zanppa/smart_socket/docs/main_page.png

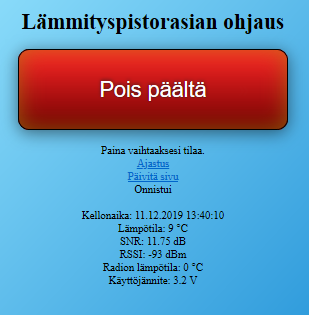
docs/main_page.png
