zanppa/smart_socket/docs/timing.png

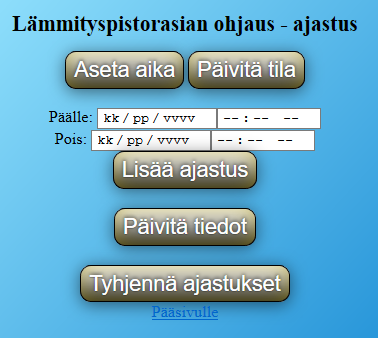
docs/timing.png
