zanppa/smart_socket/README.md

# smart_socket
A "smart" remote controlled power socket
