zanppa/smart_socket/model/readme.md

This directory contains 3D model(s) for the smart socket (concepts).
