zanppa/smart_socket/model/horizontal.png

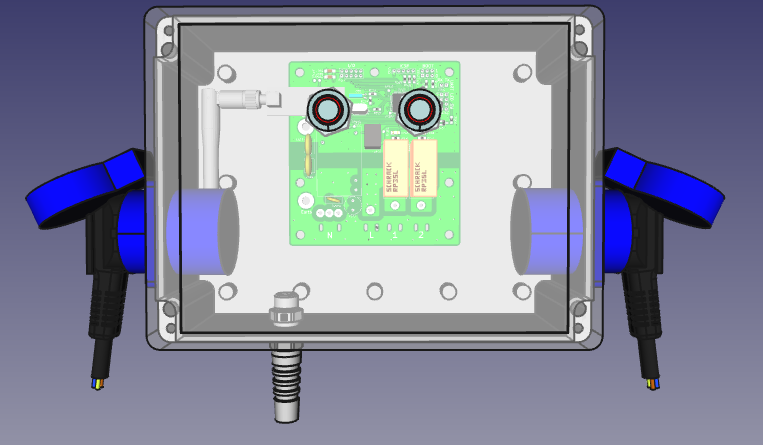
model/horizontal.png
