zanppa/smart_socket/model/vertical.png

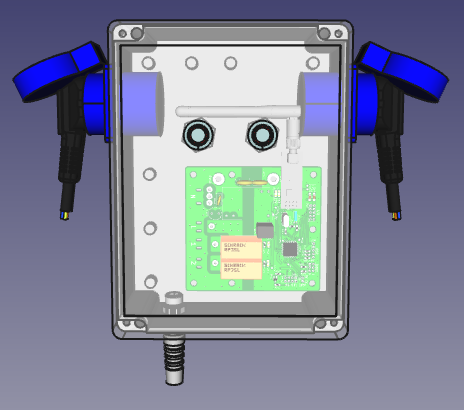
model/vertical.png
