zanppa/smart_socket/model/Horizontal_1.FCStd

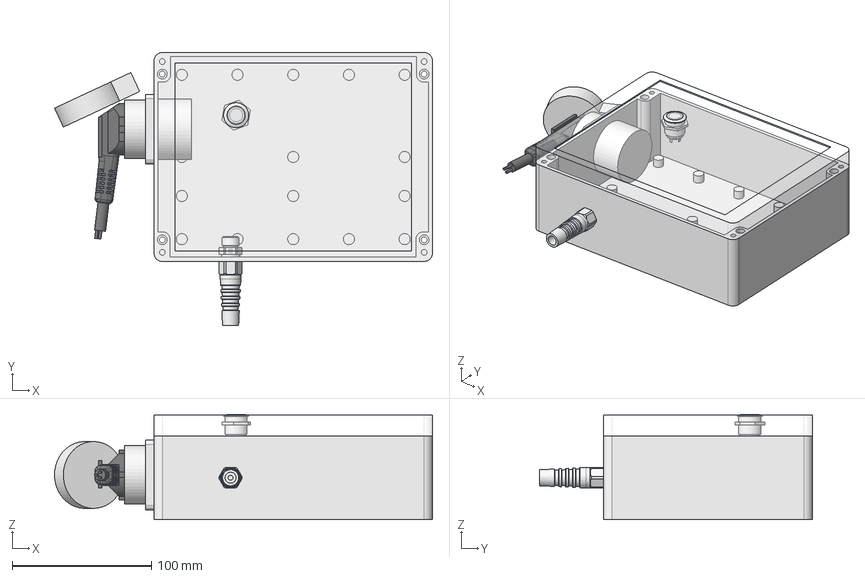
[picture p5: CAD file, 2020-01-01]
model/Horizontal_1.FCStd
271.4 x 196.0 x 75.4 mm
Kotelo
Kansi
Button
Pistorasia1
M12 cable gland
