zanppa/smart_socket/model/Vertical_1.FCStd

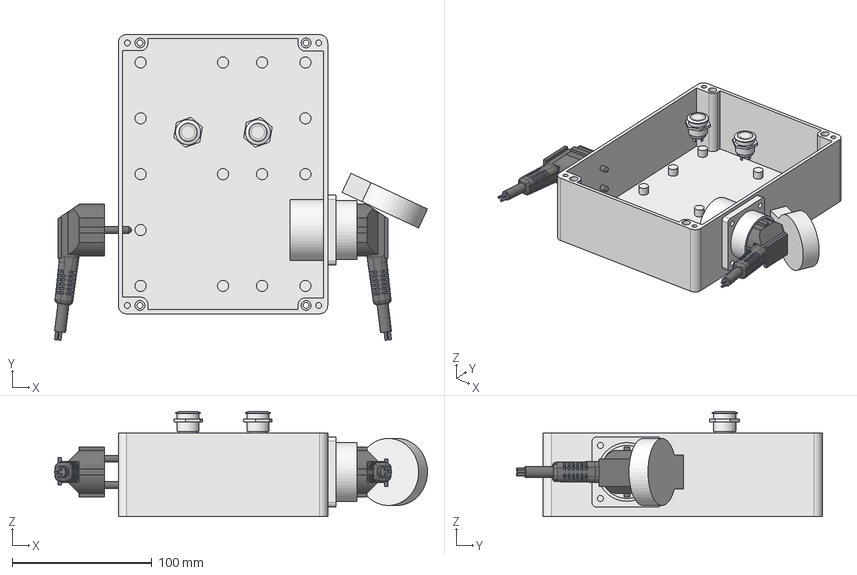
[picture p6: CAD file, 2020-01-01]
model/Vertical_1.FCStd
267.1 x 219.1 x 75.4 mm
Kotelo
Button1
Pistorasia2
Button2
