zanppa/smart_socket/electronics/gerbers/Socket-B.SilkS.pdf

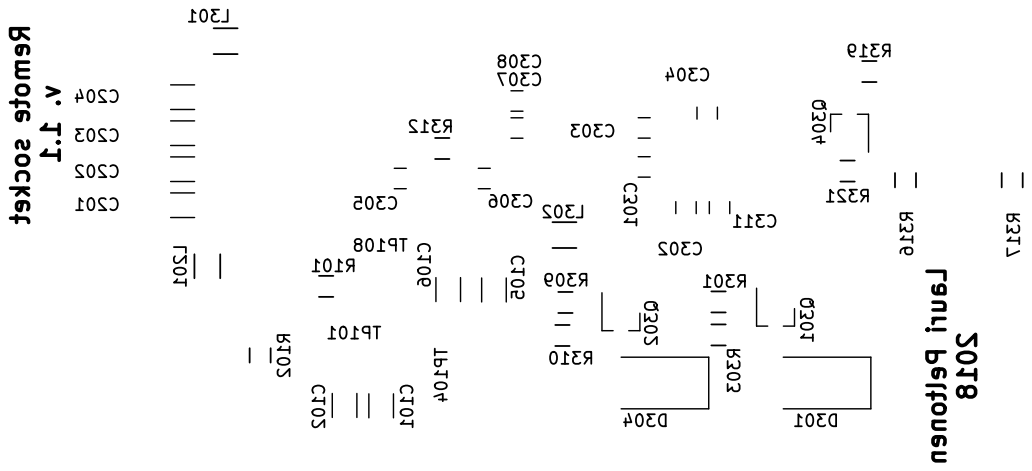
[picture p7: page 1]

Lauri Peltonen 2018 Remote socket v. 1.1
