zanppa/smart_socket/electronics/schematic/socket.pdf

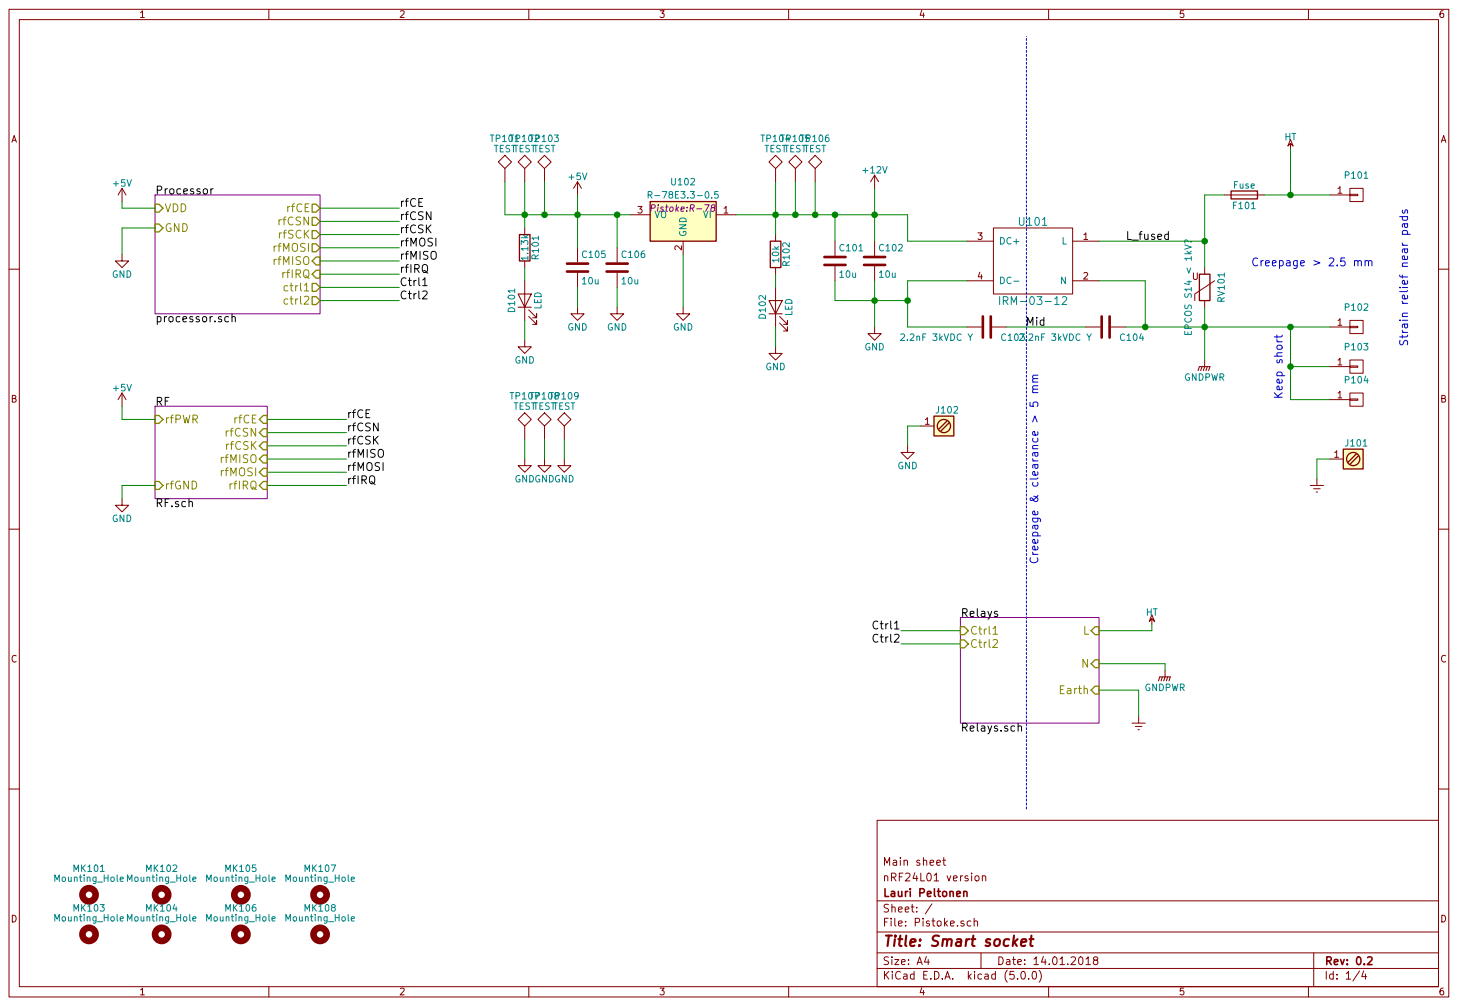
[picture p8: page 1]

1 P104 Processor processor.sch VDD GND

Id: 1/4 Title: Smart socket File: Pistoke.sch Sheet: / Lauri Peltonen

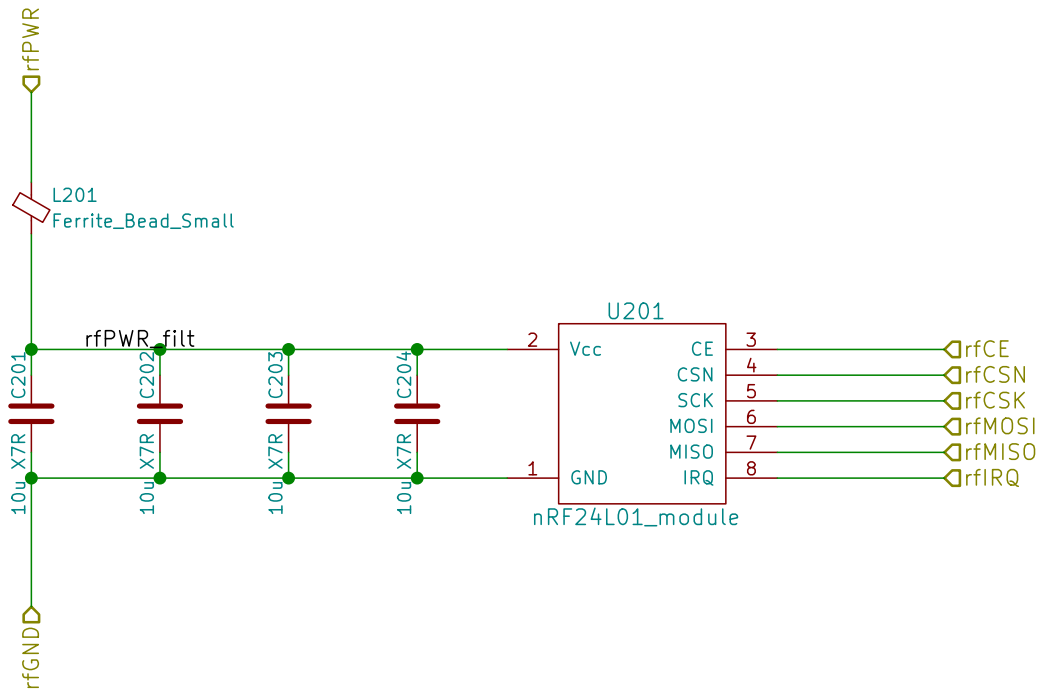
[picture p9: page 2]

Id: 2/4 Title: Smart socket File: RF.sch Sheet: /RF/ Lauri Peltonen

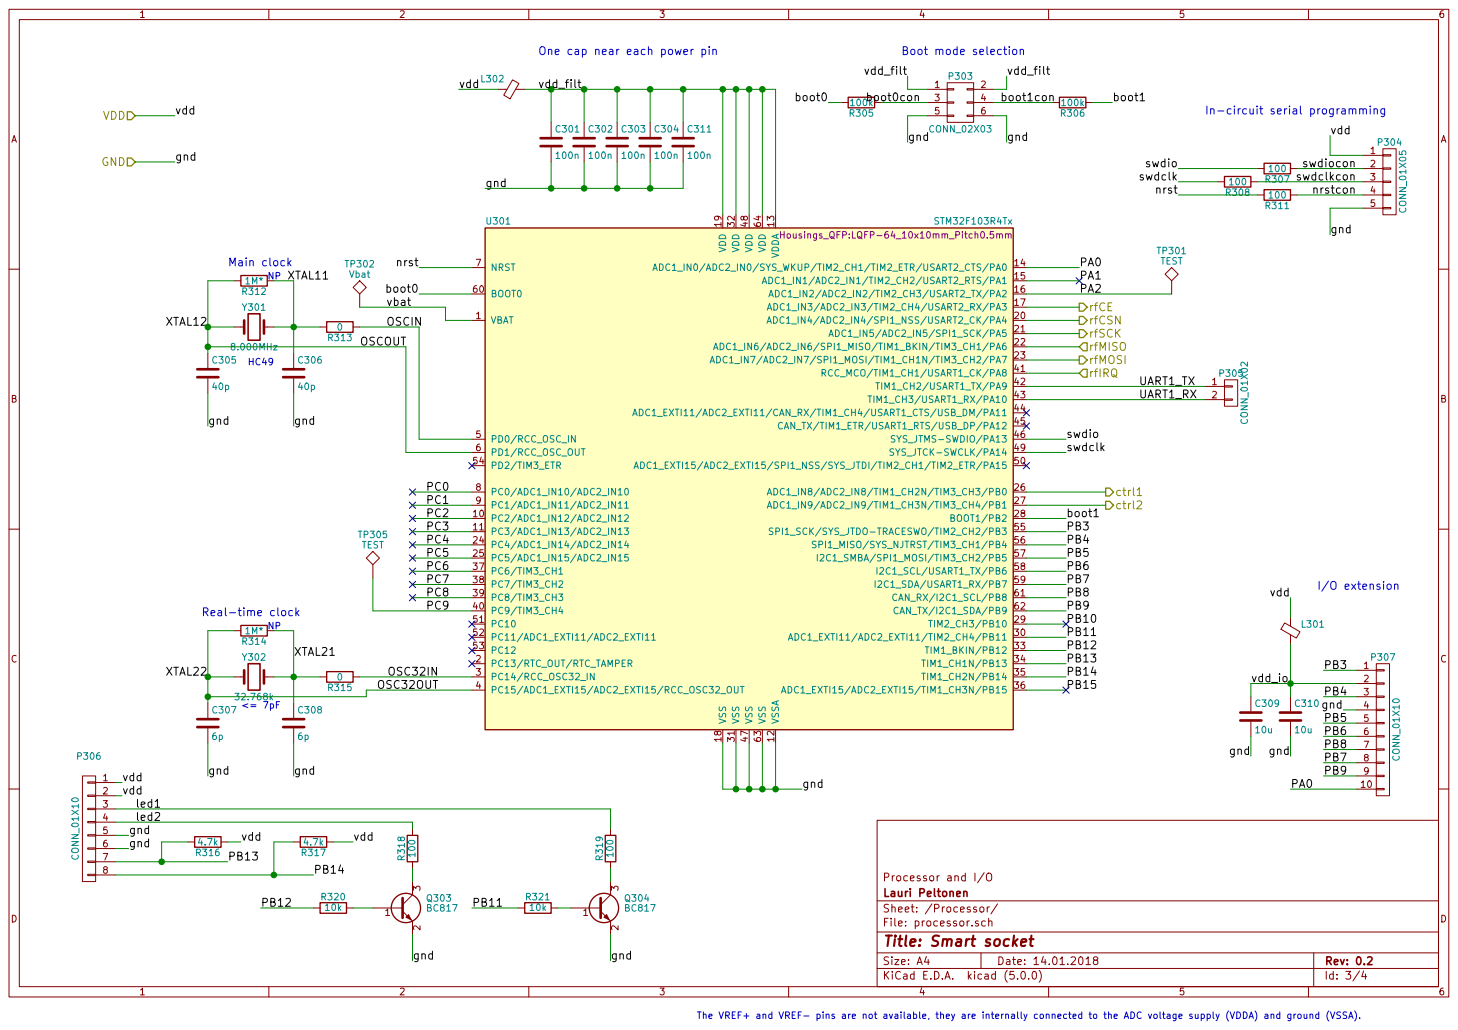
[picture p10: page 3]

One cap near each power pin

In-circuit serial programming

File: processor.sch Sheet: /Processor/ Lauri Peltonen Processor and I/O

Id: 3/4 Title: Smart socket

The VREF+ and VREF- pins are not available, they are internally connected to the ADC voltage supply (VDDA) and ground (VSSA).

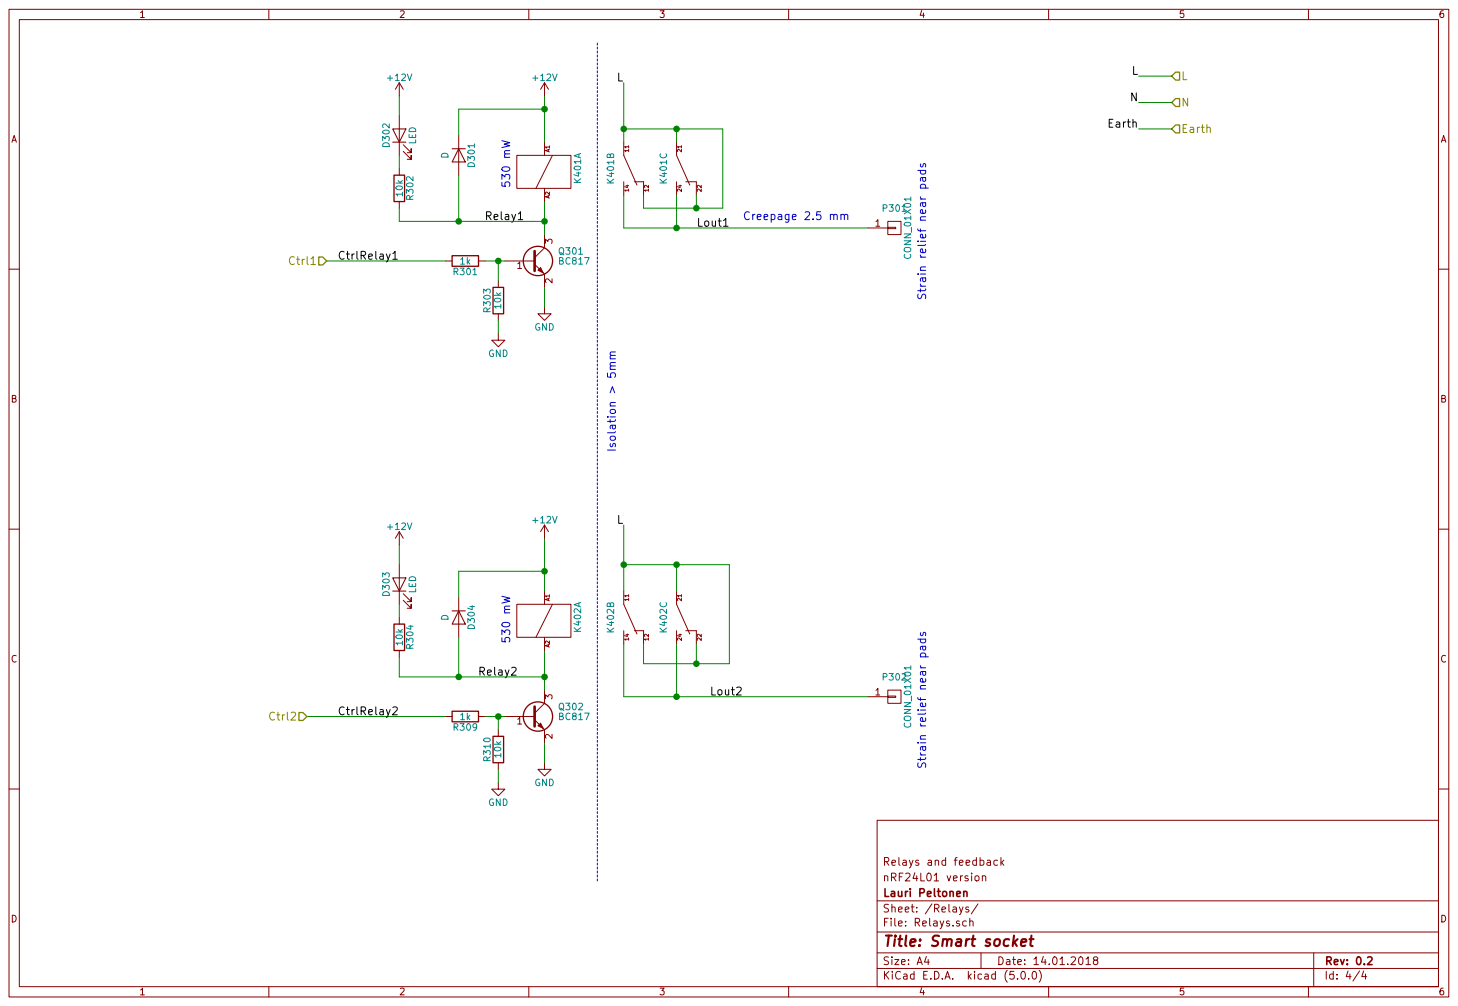
[picture p11: page 4]

Sheet: /Relays/ Lauri Peltonen

File: Relays.sch
Id: 4/4 Title: Smart socket
