zanppa/smart_socket/electronics/gerbers/Socket-B.Cu.pdf

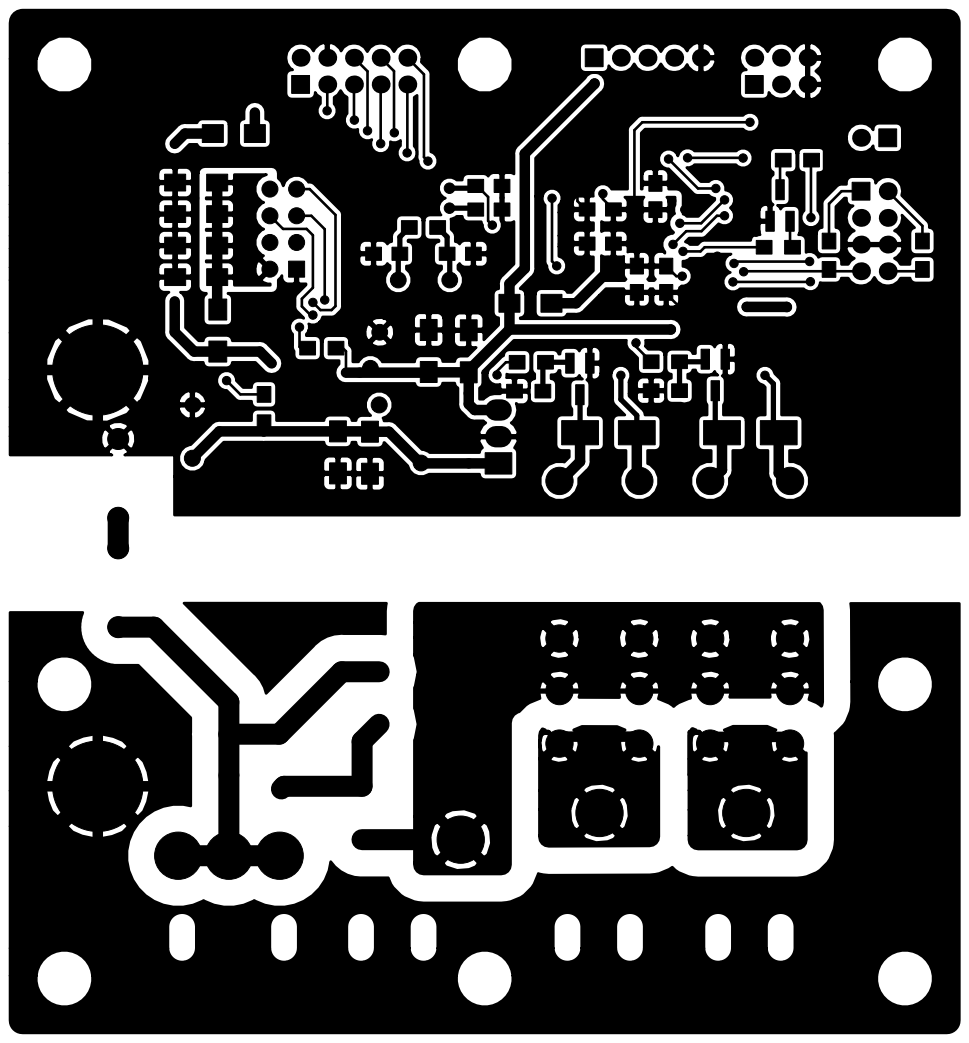
[picture p12: page 1]
