zanppa/smart_socket/electronics/gerbers/Socket-B.Mask.pdf

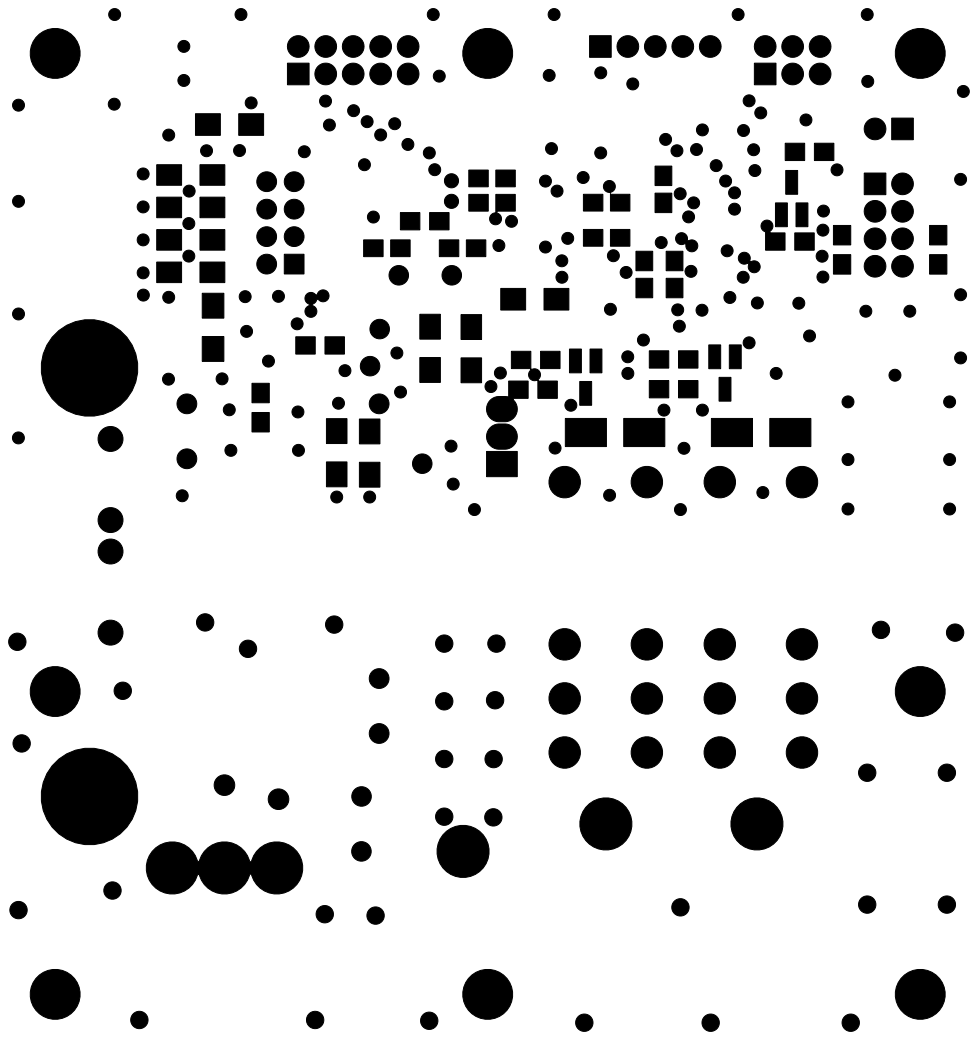
[picture p13: page 1]
