zanppa/smart_socket/electronics/gerbers/Socket-Edge.Cuts.pdf

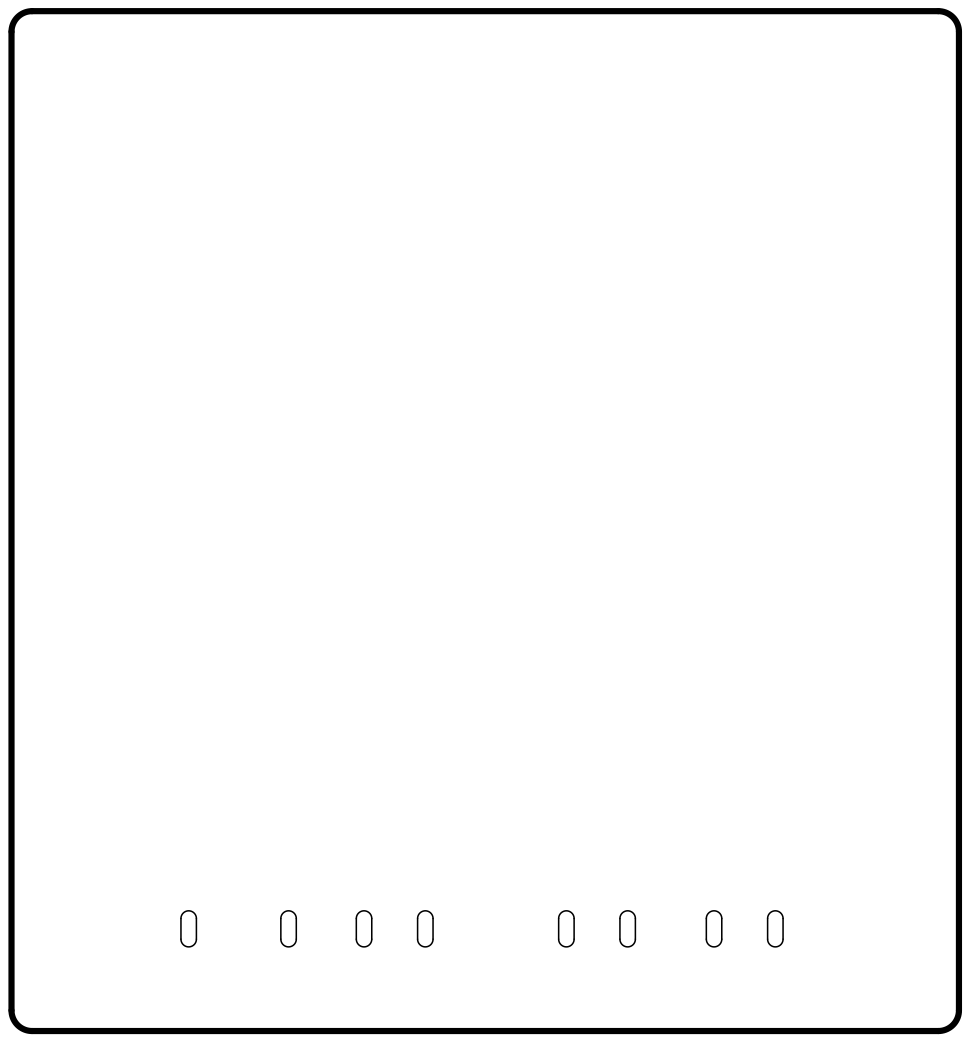
[picture p14: page 1]
