zanppa/smart_socket/electronics/gerbers/Socket-F.Cu.pdf

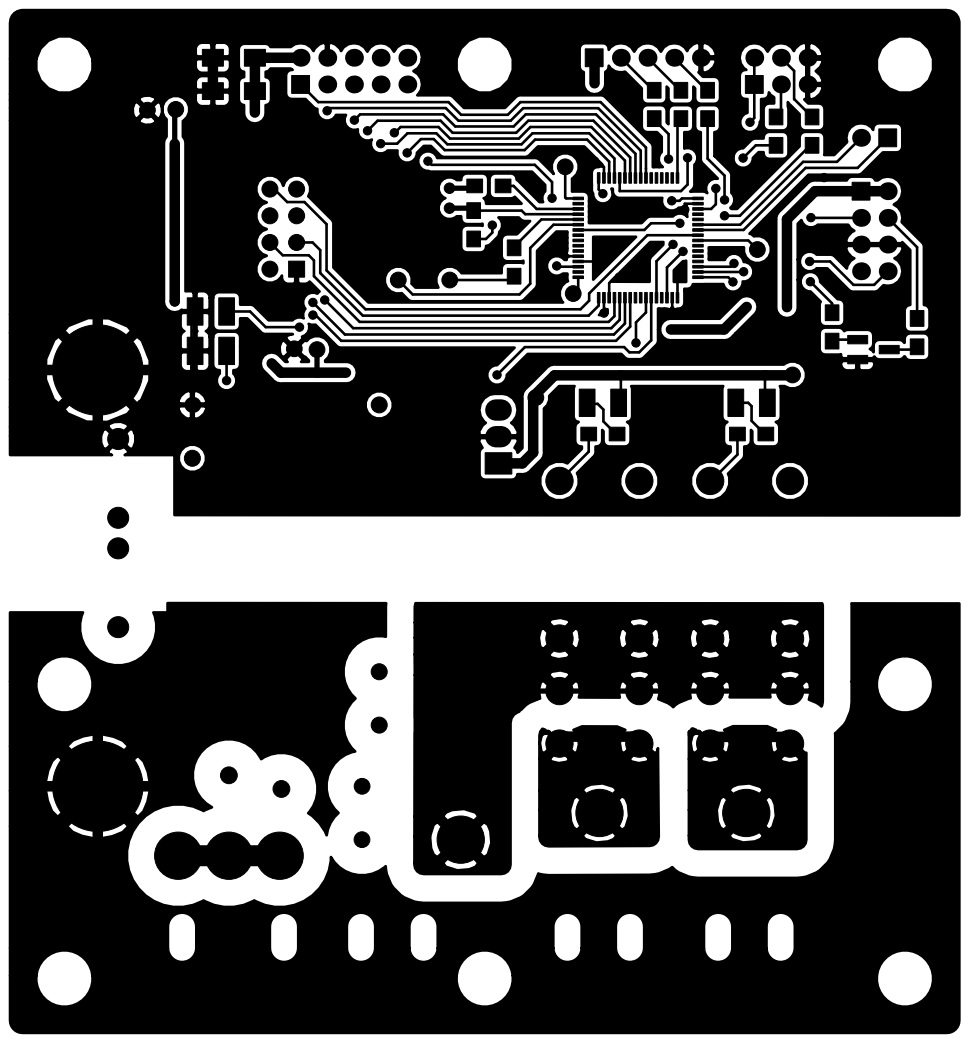
[picture p15: page 1]
