zanppa/smart_socket/electronics/gerbers/Socket-F.Mask.pdf

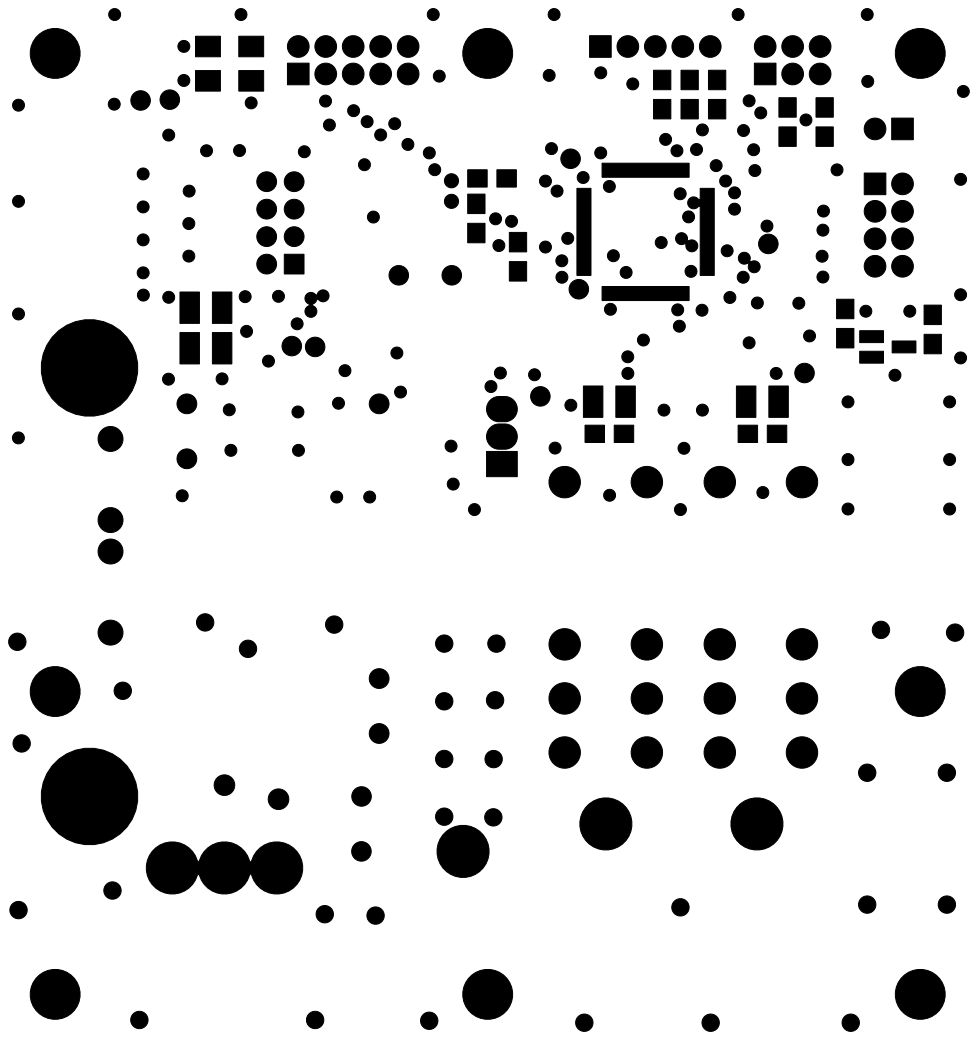
[picture p16: page 1]
