zanppa/smart_socket/electronics/gerbers/Socket-F.SilkS.pdf

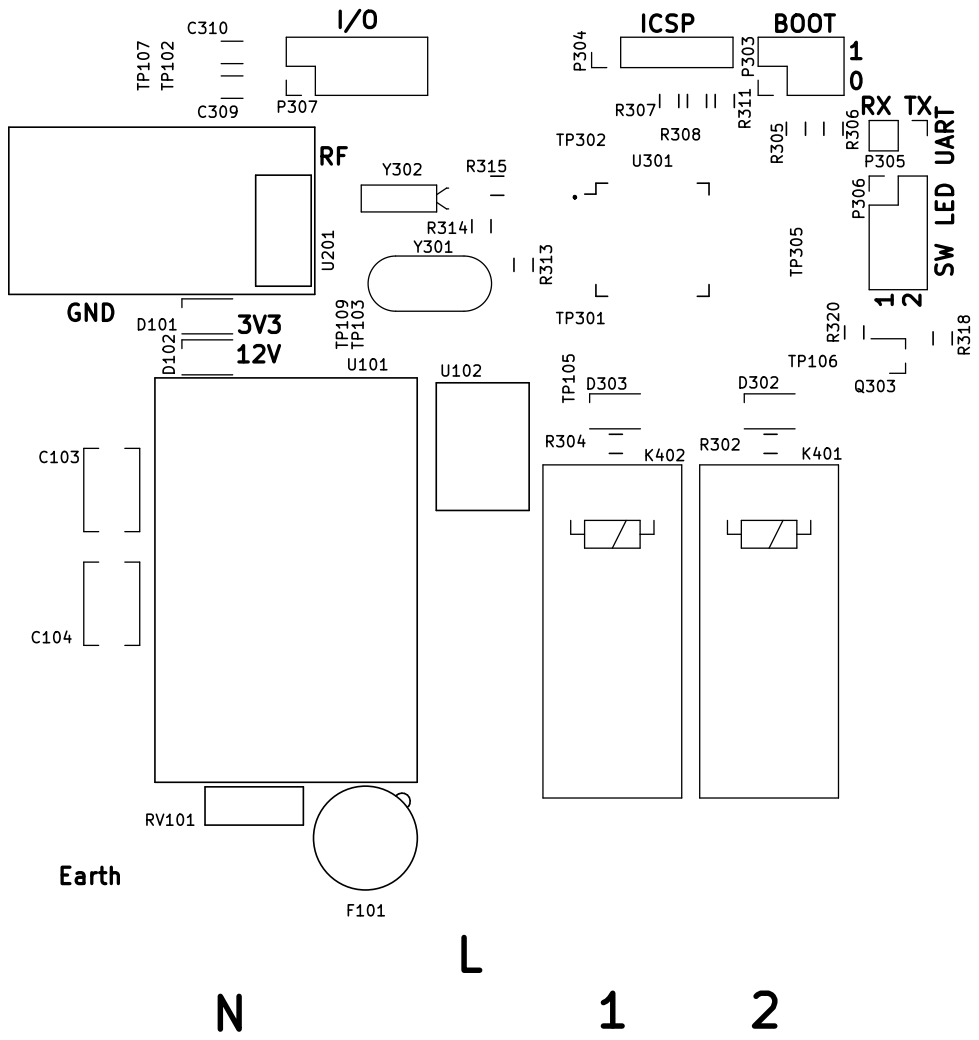
[picture p17: page 1]
