zanppa/smart_socket/electronics/kicad/Socket.kicad_pcb

## KiCad design electronics/kicad/Socket.kicad_pcb (2020-01-02)

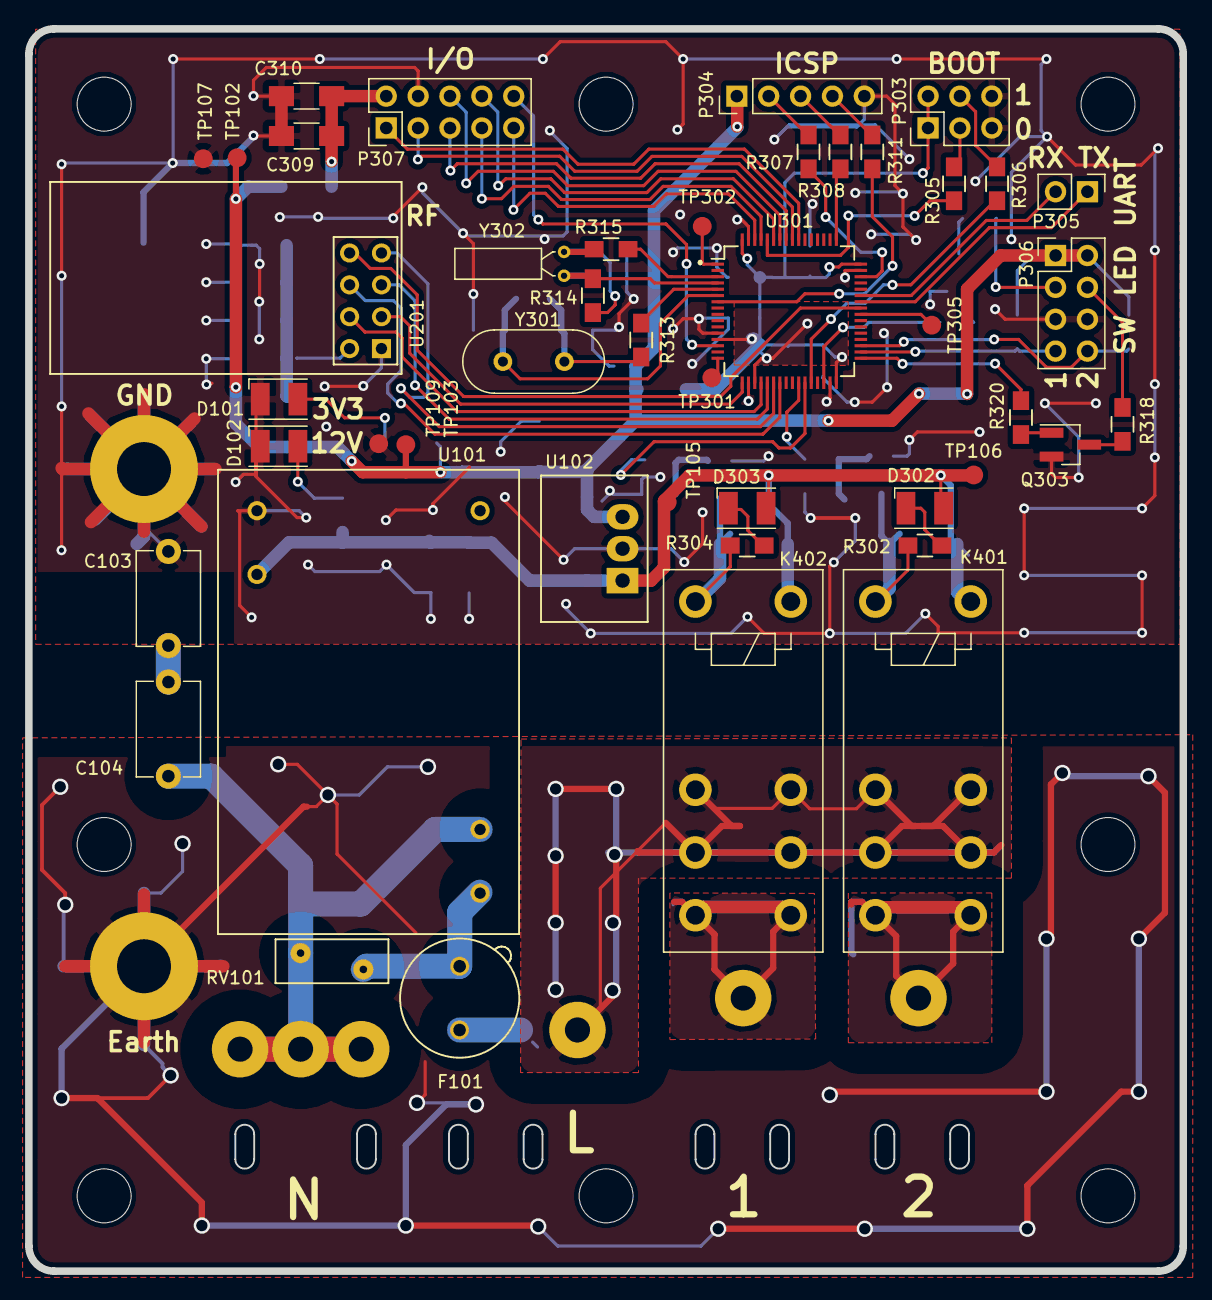
[picture p18: board Socket.kicad_pcb from above]

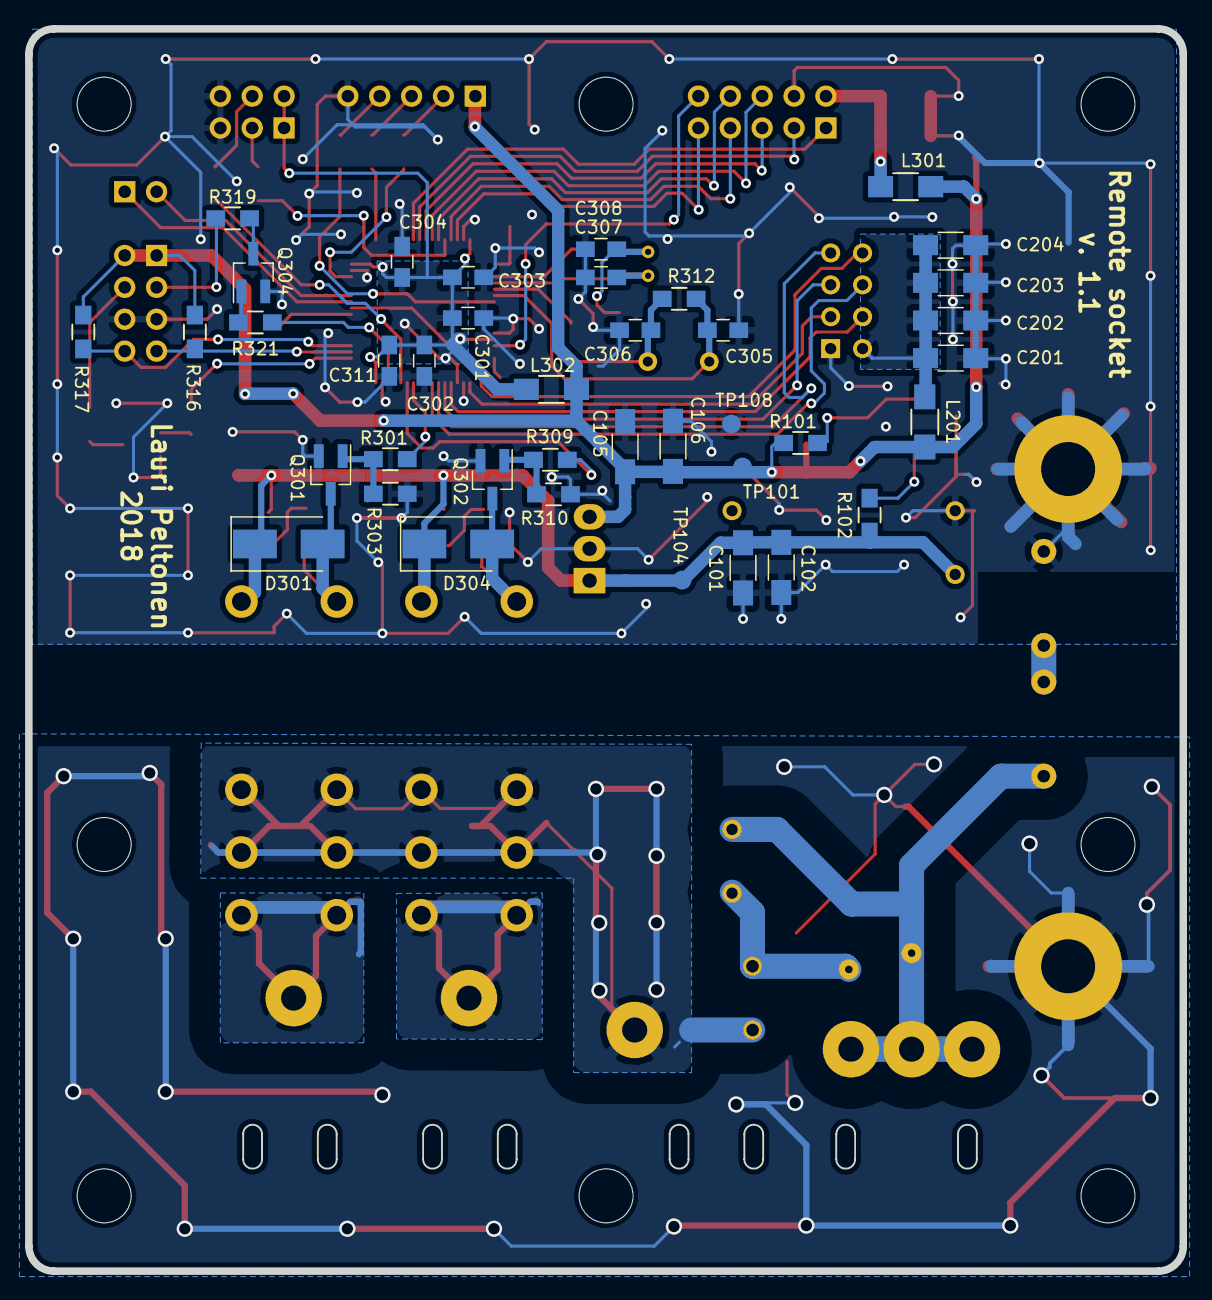
[picture p19: board Socket.kicad_pcb from below]

Board: 2 copper layers, 92.0 x 99.0 mm, 100 parts (39 on the bottom side), 67 nets.

Parts:
C101, C102, C105, C106, C309, C310: 10u; C_1206_HandSoldering
C103, C104: 2.2nF 3kVDC Y; C_Disc_D7.5mm_W5.0mm_P7.50mm
C201, C202, C203, C204: 10u X7R; C_1206_HandSoldering
C301, C302, C303, C304, C311: 100n; C_0805_HandSoldering
C305, C306: 40p; C_0805_HandSoldering
C307, C308: 8p; C_0805_HandSoldering
D101, D102, D302, D303: LED; LED_PLCC-2
D301, D304: D; D_SMB_Handsoldering
F101: Fuse; Fuseholder_Fuse_TR5_Littlefuse-No560_No460
J101, J102: Screw_Terminal_1x01; MountingHole_4.3mm_M4_Pad
K401, K402: GZSH-12V; Relay_SPDT_Goodsky_GZ
L201, L301, L302: Ferrite_Bead_Small; R_1206_HandSoldering
MK101, MK102, MK103, MK104, MK105, MK106, MK107, MK108: Mounting_Hole; MountingHole_4.3mm_M4
P101, P102, P103, P104, P301, P302: CONN_01X01; SolderWirePad_single_2mmDrill
P303: CONN_02X03; Pin_Header_Straight_2x03_Pitch2.54mm
P304: CONN_01X05; Pin_Header_Straight_1x05_Pitch2.54mm
P305: CONN_01X02; Pin_Header_Straight_1x02_Pitch2.54mm
P306: CONN_01X10; Pin_Header_Straight_2x04_Pitch2.54mm
P307: CONN_01X10; Pin_Header_Straight_2x05_Pitch2.54mm
Q301, Q302, Q303, Q304: BC817; SOT-23_Handsoldering
R101: 1.13k; R_0805_HandSoldering
R102, R302, R303, R304, R310, R320, R321: 10k; R_0805_HandSoldering
R301, R309: 1k; R_0805_HandSoldering
R305, R306: 100k; R_0805_HandSoldering
R307, R308, R311, R318, R319: 100; R_0805_HandSoldering
R312, R314: 1M*; R_0805_HandSoldering
R313, R315: 0; R_0805_HandSoldering
R316, R317: 4.7k; R_0805_HandSoldering
RV101: EPCOS S14 < 1kV?; RV_Disc_D9_W3.5_P5
TP101, TP102, TP103, TP104, TP105, TP106, TP107, TP108, TP109, TP301, TP305: TEST; Measurement_Point_Round-SMD-Pad_Small
TP302: Vbat; Measurement_Point_Round-SMD-Pad_Small
U101: IRM-03-12; IRM-03
U102: R-78E3.3-0.5; R-78
U201: nRF24L01_module
U301: STM32F103R4Tx; LQFP-64_10x10mm_Pitch0.5mm
Y301: 8.000MHz; Crystal_HC18-U_Vertical
Y302: 32.768k; Crystal_C26-LF_d2.1mm_l6.5mm_Horizontal

Connections:
+5V: C105.1, C106.1, L201.1, L301.1, L302.1, P304.1, P306.1, P306.2, R101.1, R316.1, R317.1, TP101.1, TP102.1, TP103.1, U102.3
+12V: C101.1, C102.1, D301.1, D302.2, D303.2, D304.1, K401.A1, K402.A1, R102.1, TP104.1, TP105.1, TP106.1, U101.3, U102.1
/Ctrl1: R301.2, U301.26
/Ctrl2: R309.2, U301.27
/L_fused: F101.2, RV101.2, U101.1
/Mid: C103.1, C104.2
/Processor/OSC32IN: R315.1, U301.3
/Processor/OSC32OUT: C307.1, R314.2, U301.4, Y302.2
/Processor/OSCIN: R313.1, U301.5
/Processor/OSCOUT: C305.1, R312.2, U301.6, Y301.1
/Processor/PA0: P307.10, U301.14
/Processor/PA2: TP301.1, U301.16
/Processor/PB3: P307.1, U301.55
/Processor/PB4: P307.3, U301.56
/Processor/PB5: P307.5, U301.57
/Processor/PB6: P307.6, U301.58
/Processor/PB7: P307.8, U301.59
/Processor/PB8: P307.7, U301.61
/Processor/PB9: P307.9, U301.62
/Processor/PB11: R321.1, U301.30
/Processor/PB12: R320.1, U301.33
/Processor/PB13: P306.7, R316.2, U301.34
/Processor/PB14: P306.8, R317.2, U301.35
/Processor/PC9: TP305.1, U301.40
/Processor/UART1_RX: P305.2, U301.43
/Processor/UART1_TX: P305.1, U301.42
/Processor/XTAL11: C306.1, R312.1, R313.2, Y301.2
/Processor/XTAL21: C308.1, R314.1, R315.2, Y302.1
/Processor/boot0: R305.2, U301.60
/Processor/boot0con: P303.3, R305.1
/Processor/boot1: R306.1, U301.28
/Processor/boot1con: P303.4, R306.2
/Processor/led1: P306.3, R319.2
/Processor/led2: P306.4, R318.2
/Processor/nrst: R311.2, U301.7
/Processor/nrstcon: P304.4, R311.1
/Processor/swdclk: R308.2, U301.49
/Processor/swdclkcon: P304.3, R308.1
/Processor/swdio: R307.2, U301.46
/Processor/swdiocon: P304.2, R307.1
/Processor/vbat: TP302.1, U301.1
/Processor/vdd_filt: C301.1, C302.1, C303.1, C304.1, C311.1, L302.2, P303.1, P303.2, U301.13, U301.19, U301.32, U301.48, U301.64
/Processor/vdd_io: C309.1, C310.1, L301.2, P307.2
/RF/rfPWR_filt: C201.1, C202.1, C203.1, C204.1, L201.2, U201.2
/Relays/Lout1: K401.14, K401.24, P301.1
/Relays/Lout2: K402.14, K402.24, P302.1
/Relays/Relay1: D301.2, K401.A2, Q301.3, R302.2
/Relays/Relay2: D304.2, K402.A2, Q302.3, R304.2
/rfCE: U201.3, U301.17
/rfCSK: U201.5, U301.21
/rfCSN: U201.4, U301.20
/rfIRQ: U201.8, U301.41
/rfMISO: U201.7, U301.22
/rfMOSI: U201.6, U301.23
GND: C101.2, C102.2, C103.2, C105.2, C106.2, C201.2, C202.2, C203.2, C204.2, C301.2, C302.2, C303.2, C304.2, C305.2, C306.2, C307.2, C308.2, C309.2, C310.2, C311.2, D101.1, D102.1, J102.1, P303.5, P303.6, P304.5, P306.5, P306.6, P307.4, Q301.2, Q302.2, Q303.2, Q304.2, R303.1, R310.1, TP107.1, TP108.1, TP109.1, U101.4, U102.2, U201.1, U301.12, U301.18, U301.31, U301.47, U301.63
GNDPWR: C104.1, P102.1, P103.1, P104.1, RV101.1, U101.2
HT: F101.1, K401.11, K401.12, K401.21, K401.22, K402.11, K402.12, K402.21, K402.22, P101.1
unnamed: D101.2, R101.2
unnamed: D102.2, R102.2
unnamed: D302.1, R302.1
unnamed: D303.1, R304.1
unnamed: Q301.1, R301.1, R303.2
unnamed: Q302.1, R309.1, R310.2
unnamed: Q303.1, R320.2
unnamed: Q303.3, R318.1
unnamed: Q304.1, R321.2
unnamed: Q304.3, R319.1
